Abdullbasit/vhtd-pv-pump-drive/firmware/source/README.txt

FOC source: repository root (Keil MDK project MDK-ARM/vfd_vsi_new_50k.uvprojx, drive/ MOTOR_FOC/ comm/). V/f source: ../hs300_src_0826_ota (same project name).
