Abdullbasit/vhtd-pv-pump-drive/figures/fig06_real_clouds.png

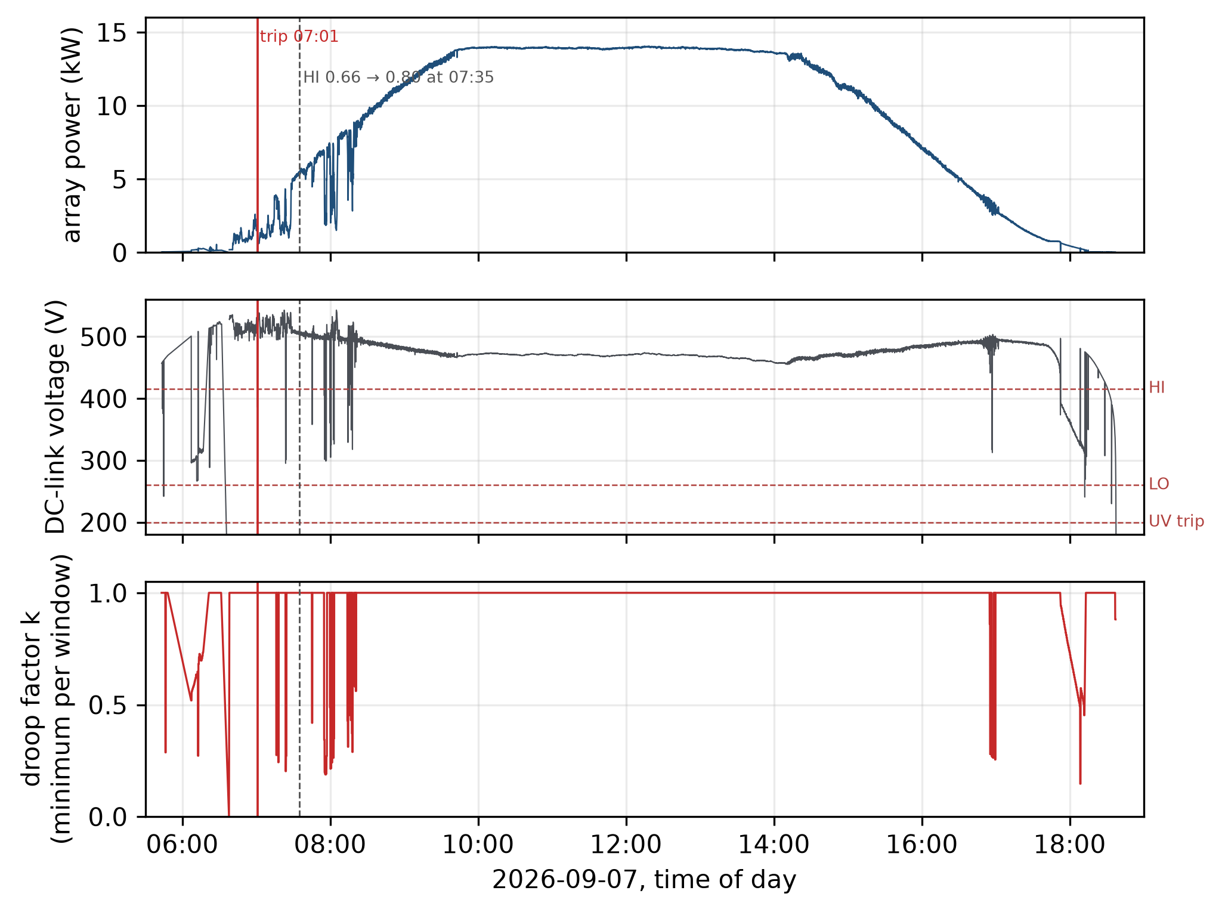
figures/fig06_real_clouds.png
