Abdullbasit/vhtd-pv-pump-drive/figures/fig09_B3_trip.png

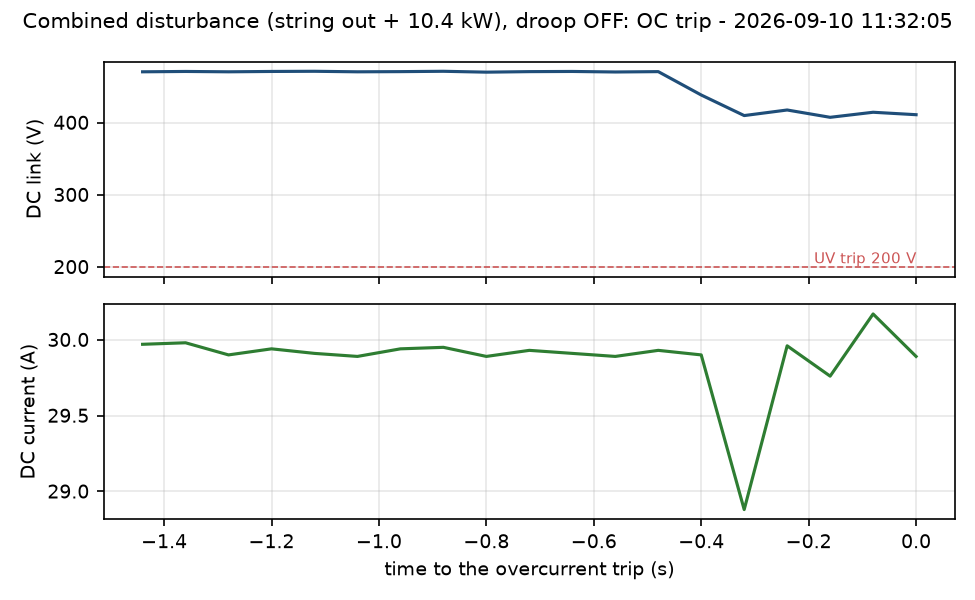
figures/fig09_B3_trip.png
