Abdullbasit/vhtd-pv-pump-drive/figures/fig10_A6_combined_droop.png

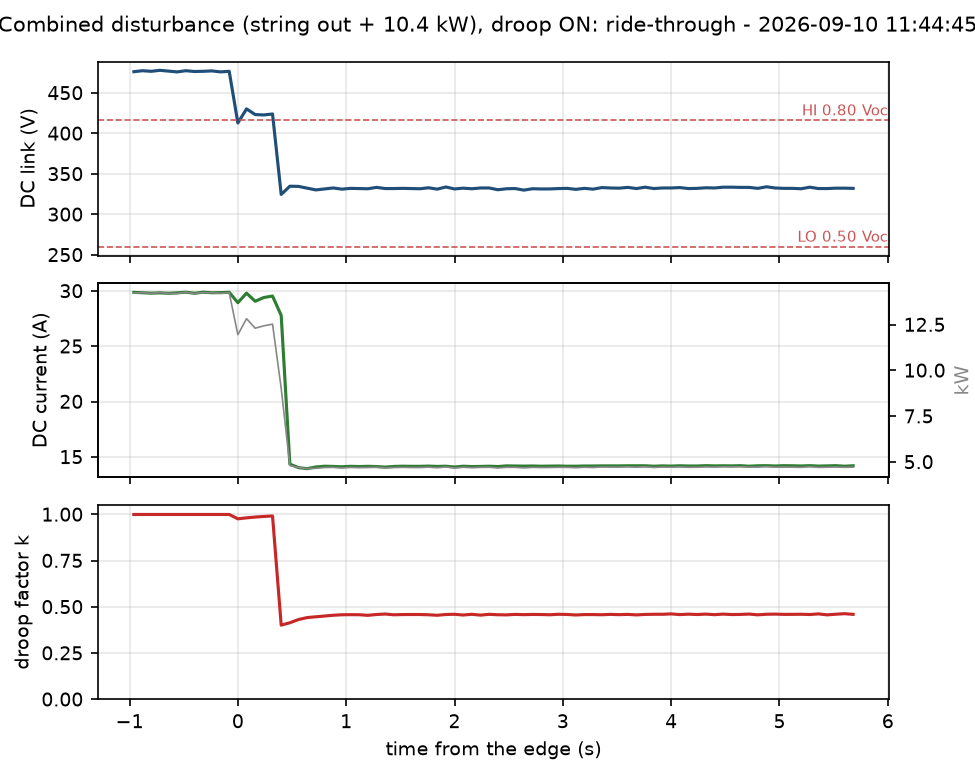
figures/fig10_A6_combined_droop.png
