Abdullbasit/vhtd-pv-pump-drive/figures/fig11_day_arc_20260910.png

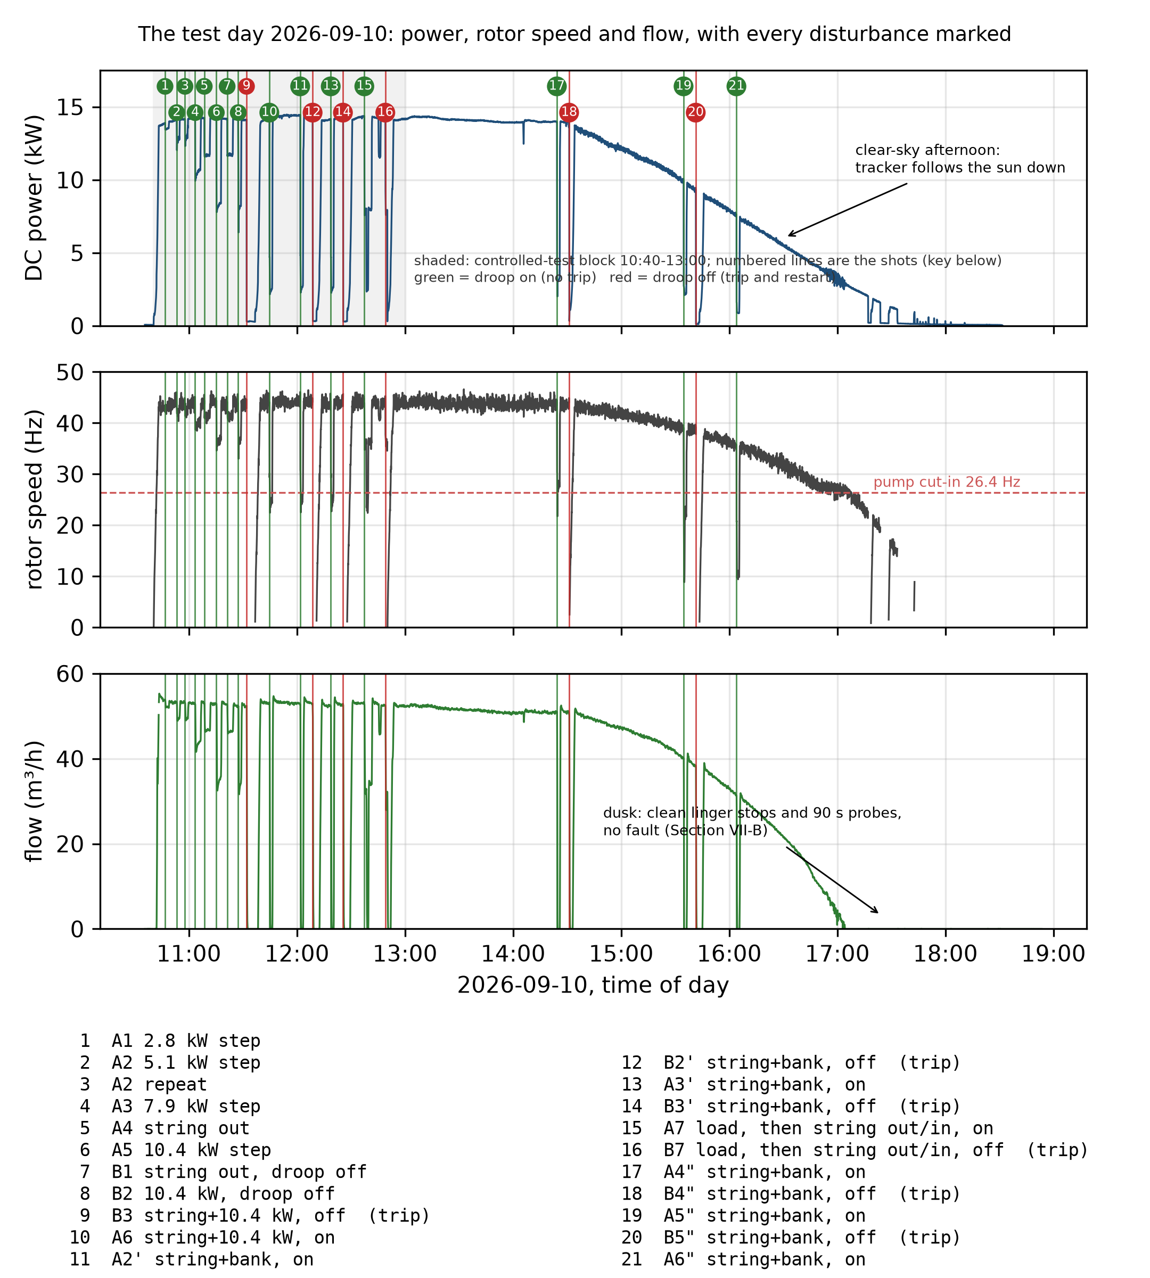
figures/fig11_day_arc_20260910.png
