Abdullbasit/vhtd-pv-pump-drive/hardware/bom_cpl_jlcpcb/notes.txt

R41,330K,1206,C144497,-49.0515,-111.604,TOP,135
R64,330K,1206,C144497,-43.9715,-110.334,TOP,135
R65,330K,1206,C144497,-50.165,-104.445,TOP,90
R68,330K,1206,C144497,-45.085,-104.445,TOP,90
R69,330K,1206,C144497,-42.2402,-119.38,TOP,180
R72,330K,1206,C144497,-36.3515,-114.779,TOP,135
R77,330K,1206,C144497,-45.2415,-115.414,TOP,135
R78,330K,1206,C144497,-40.1615,-114.144,TOP,135
AC1,CONN-SIL4,XH_254_4P2,C5341203,-40.64,-123.19,TOP,180
