Abdullbasit/vhtd-pv-pump-drive/figures/fig07_step_5kW.png

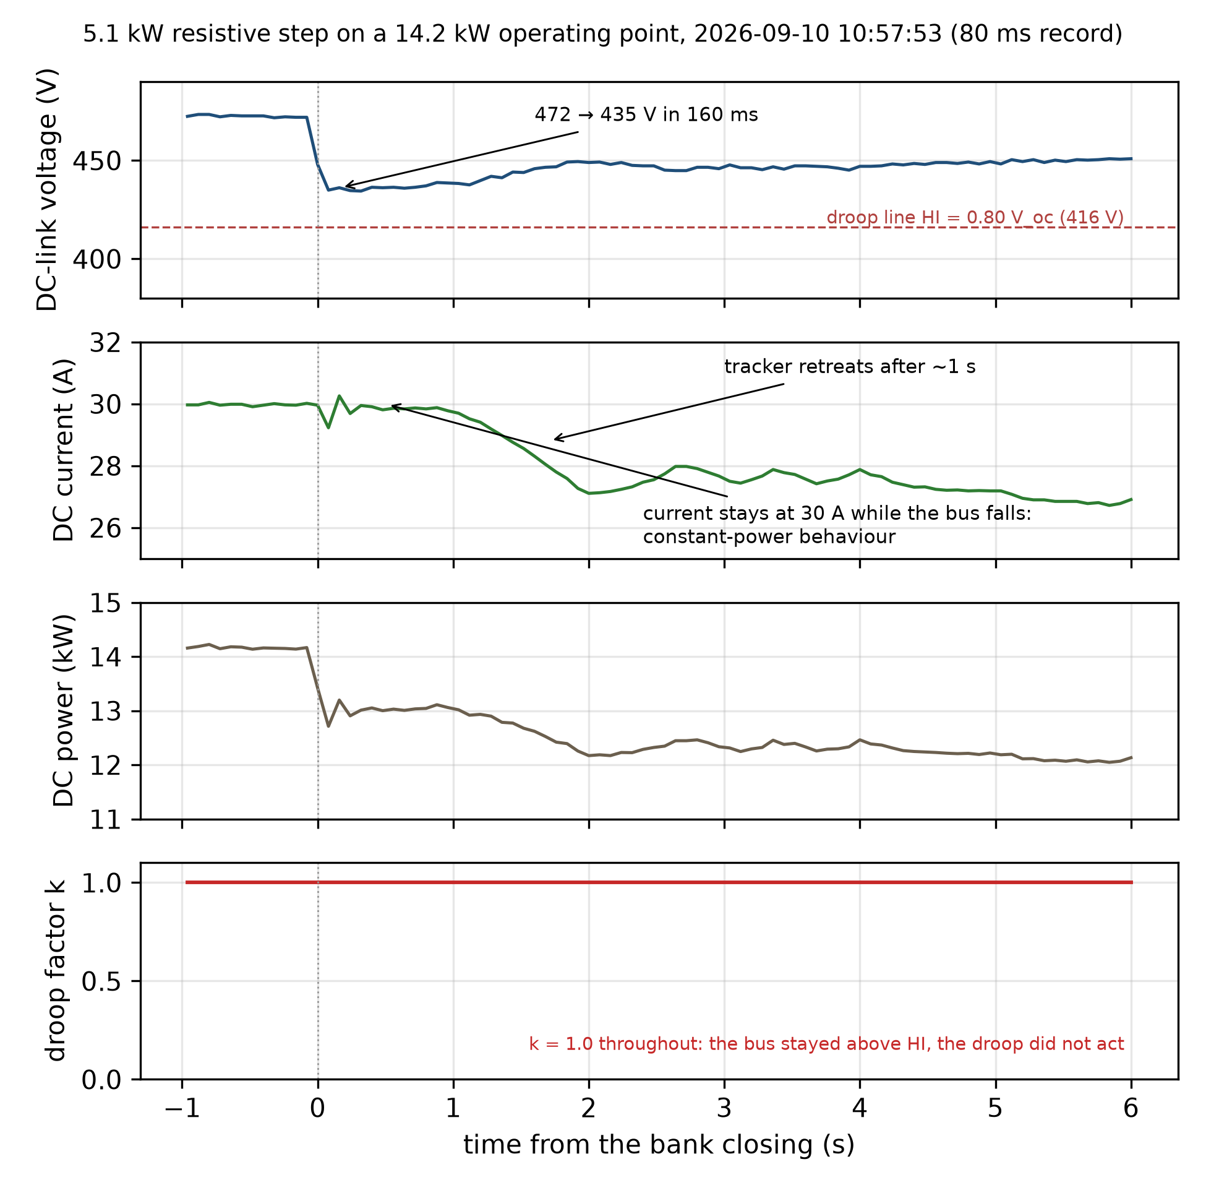
figures/fig07_step_5kW.png
