Abdullbasit/vhtd-pv-pump-drive/figures/fig08_step_12kW_droop.png

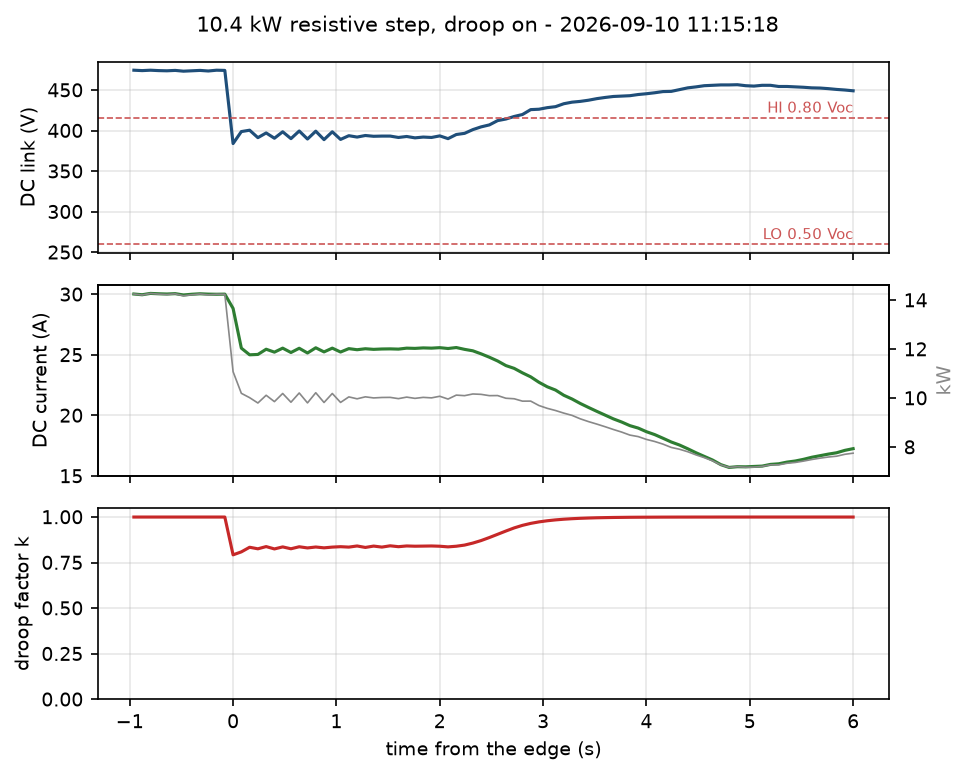
figures/fig08_step_12kW_droop.png
