Abdullbasit/vhtd-pv-pump-drive/figures/fig15_setup_schematic.png

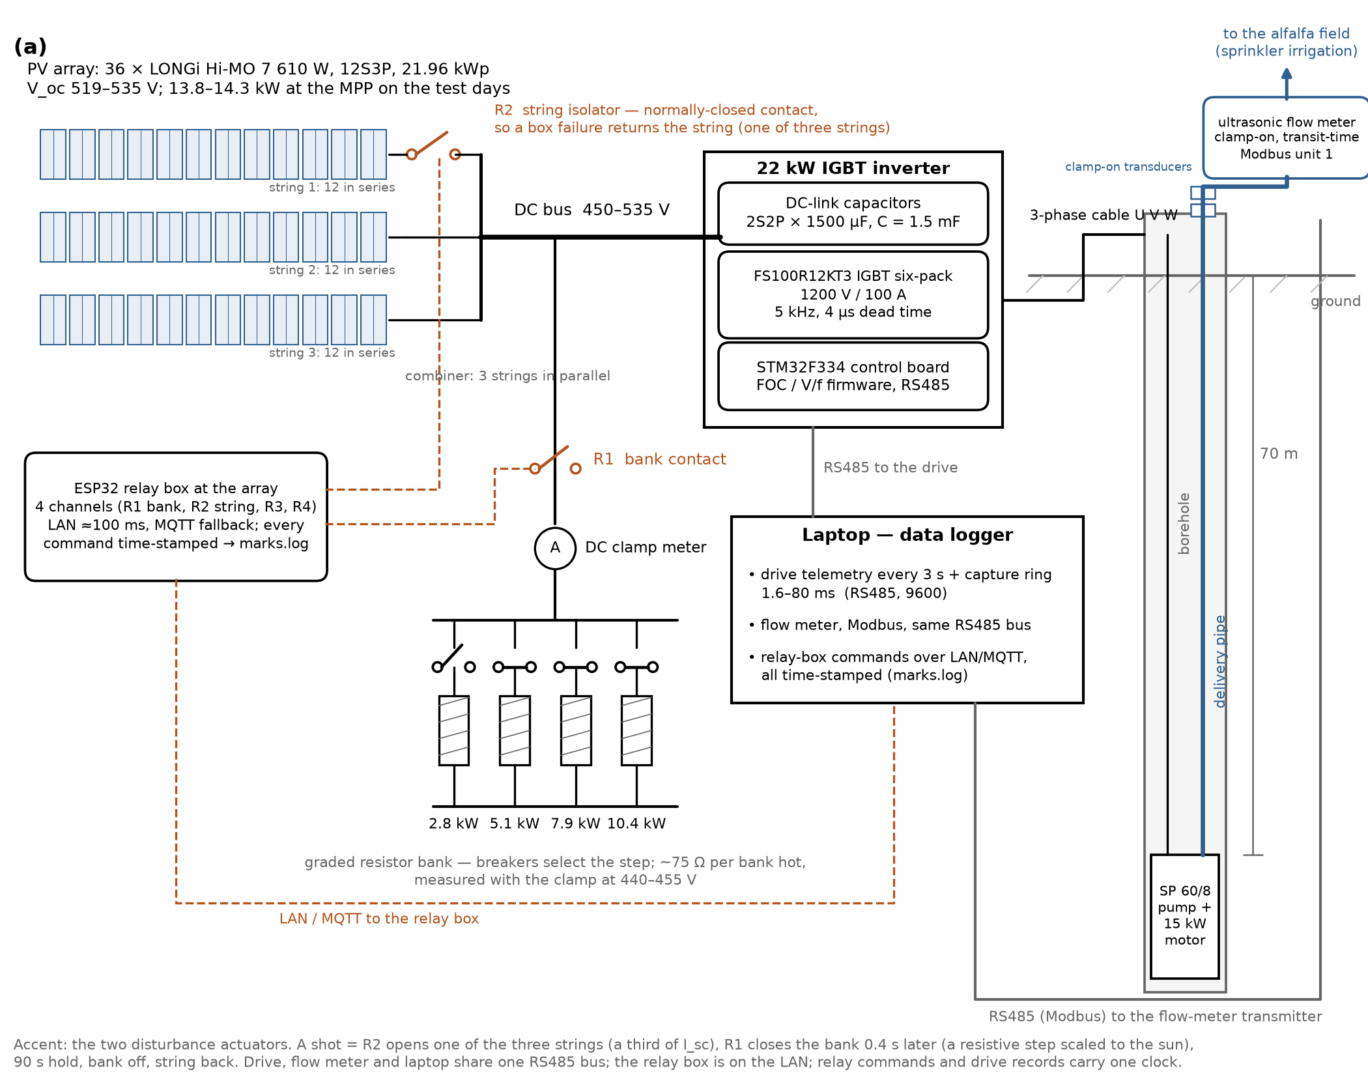
figures/fig15_setup_schematic.png
