Abdullbasit/vhtd-pv-pump-drive/figures/fig15b_setup_photos.png

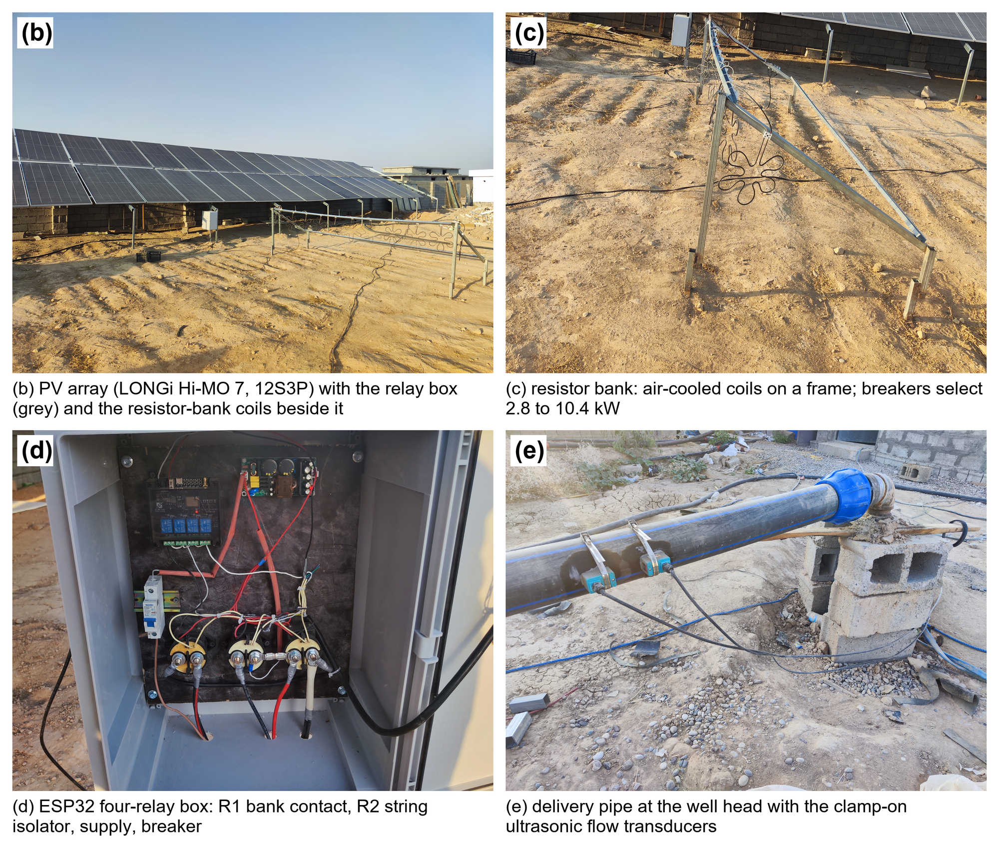
figures/fig15b_setup_photos.png
