Abdullbasit/vhtd-pv-pump-drive/figures/fig15c_setup_photos.png

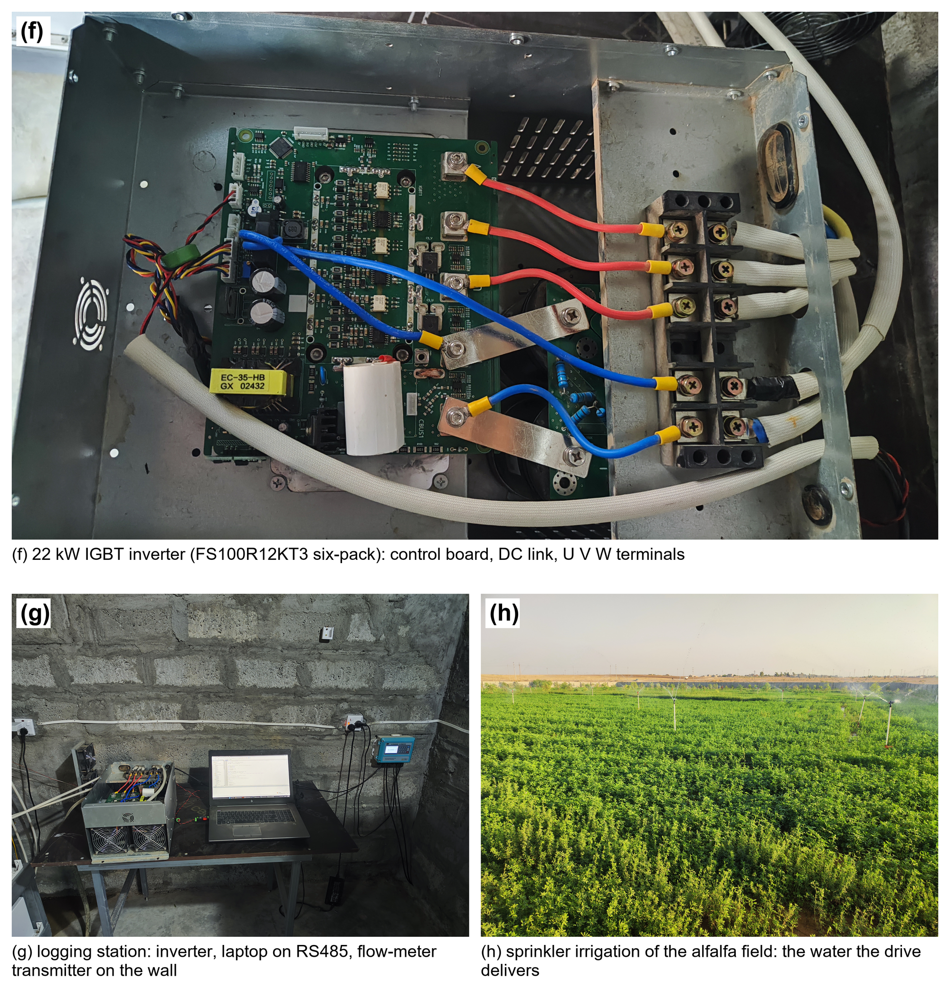
figures/fig15c_setup_photos.png
