Abdullbasit/vhtd-pv-pump-drive/hardware/schematics/HS300_sch_1_mcu.pdf

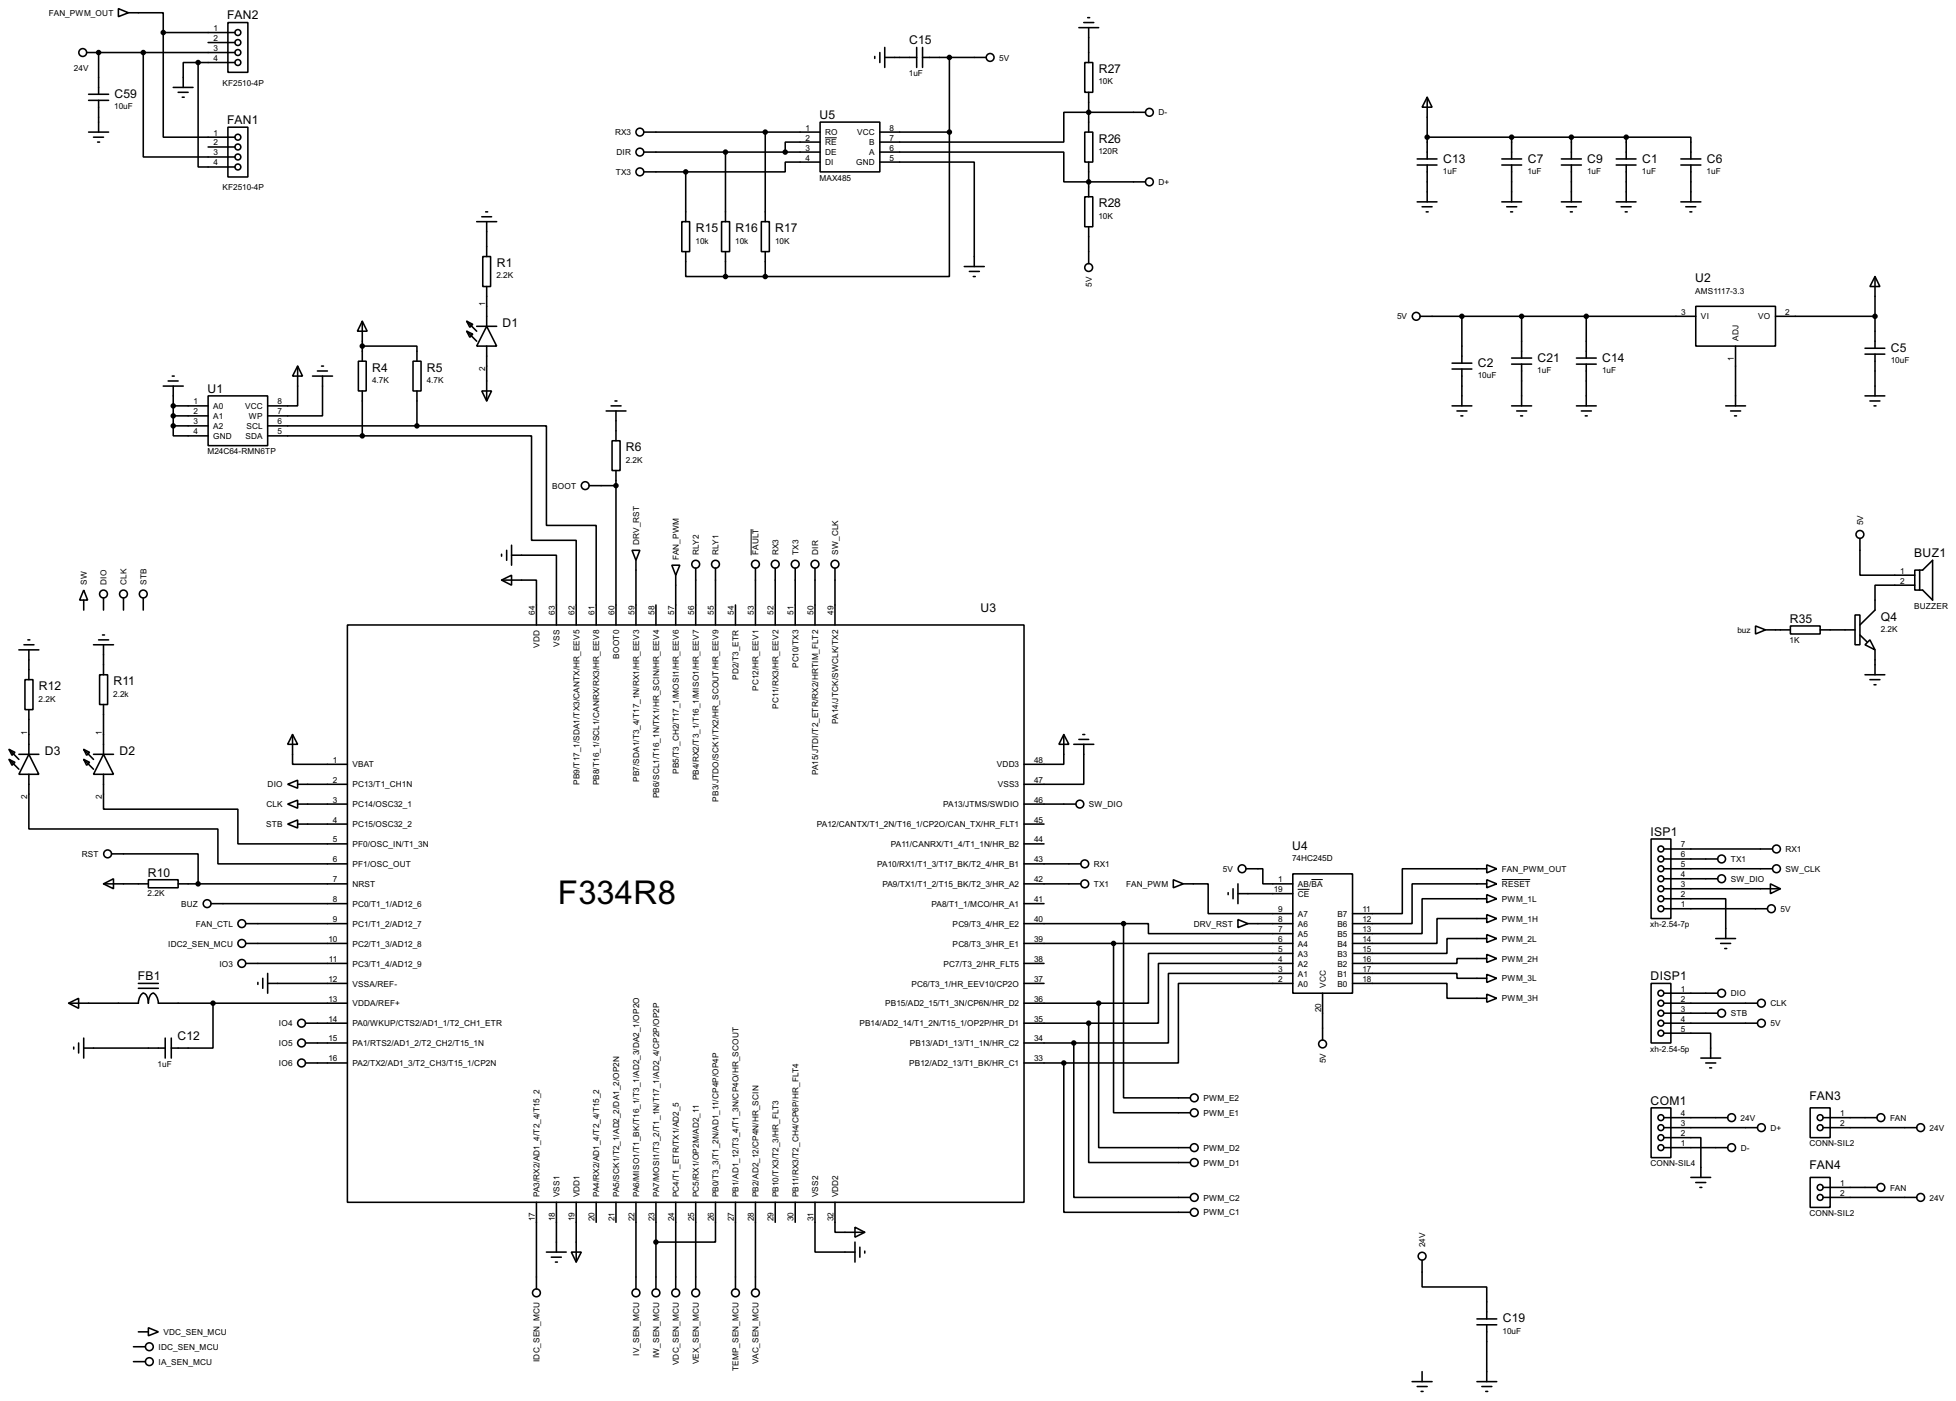
[picture p25: page 1]
