Abdullbasit/vhtd-pv-pump-drive/hardware/schematics/HS300_sch_2_gate_drivers.pdf

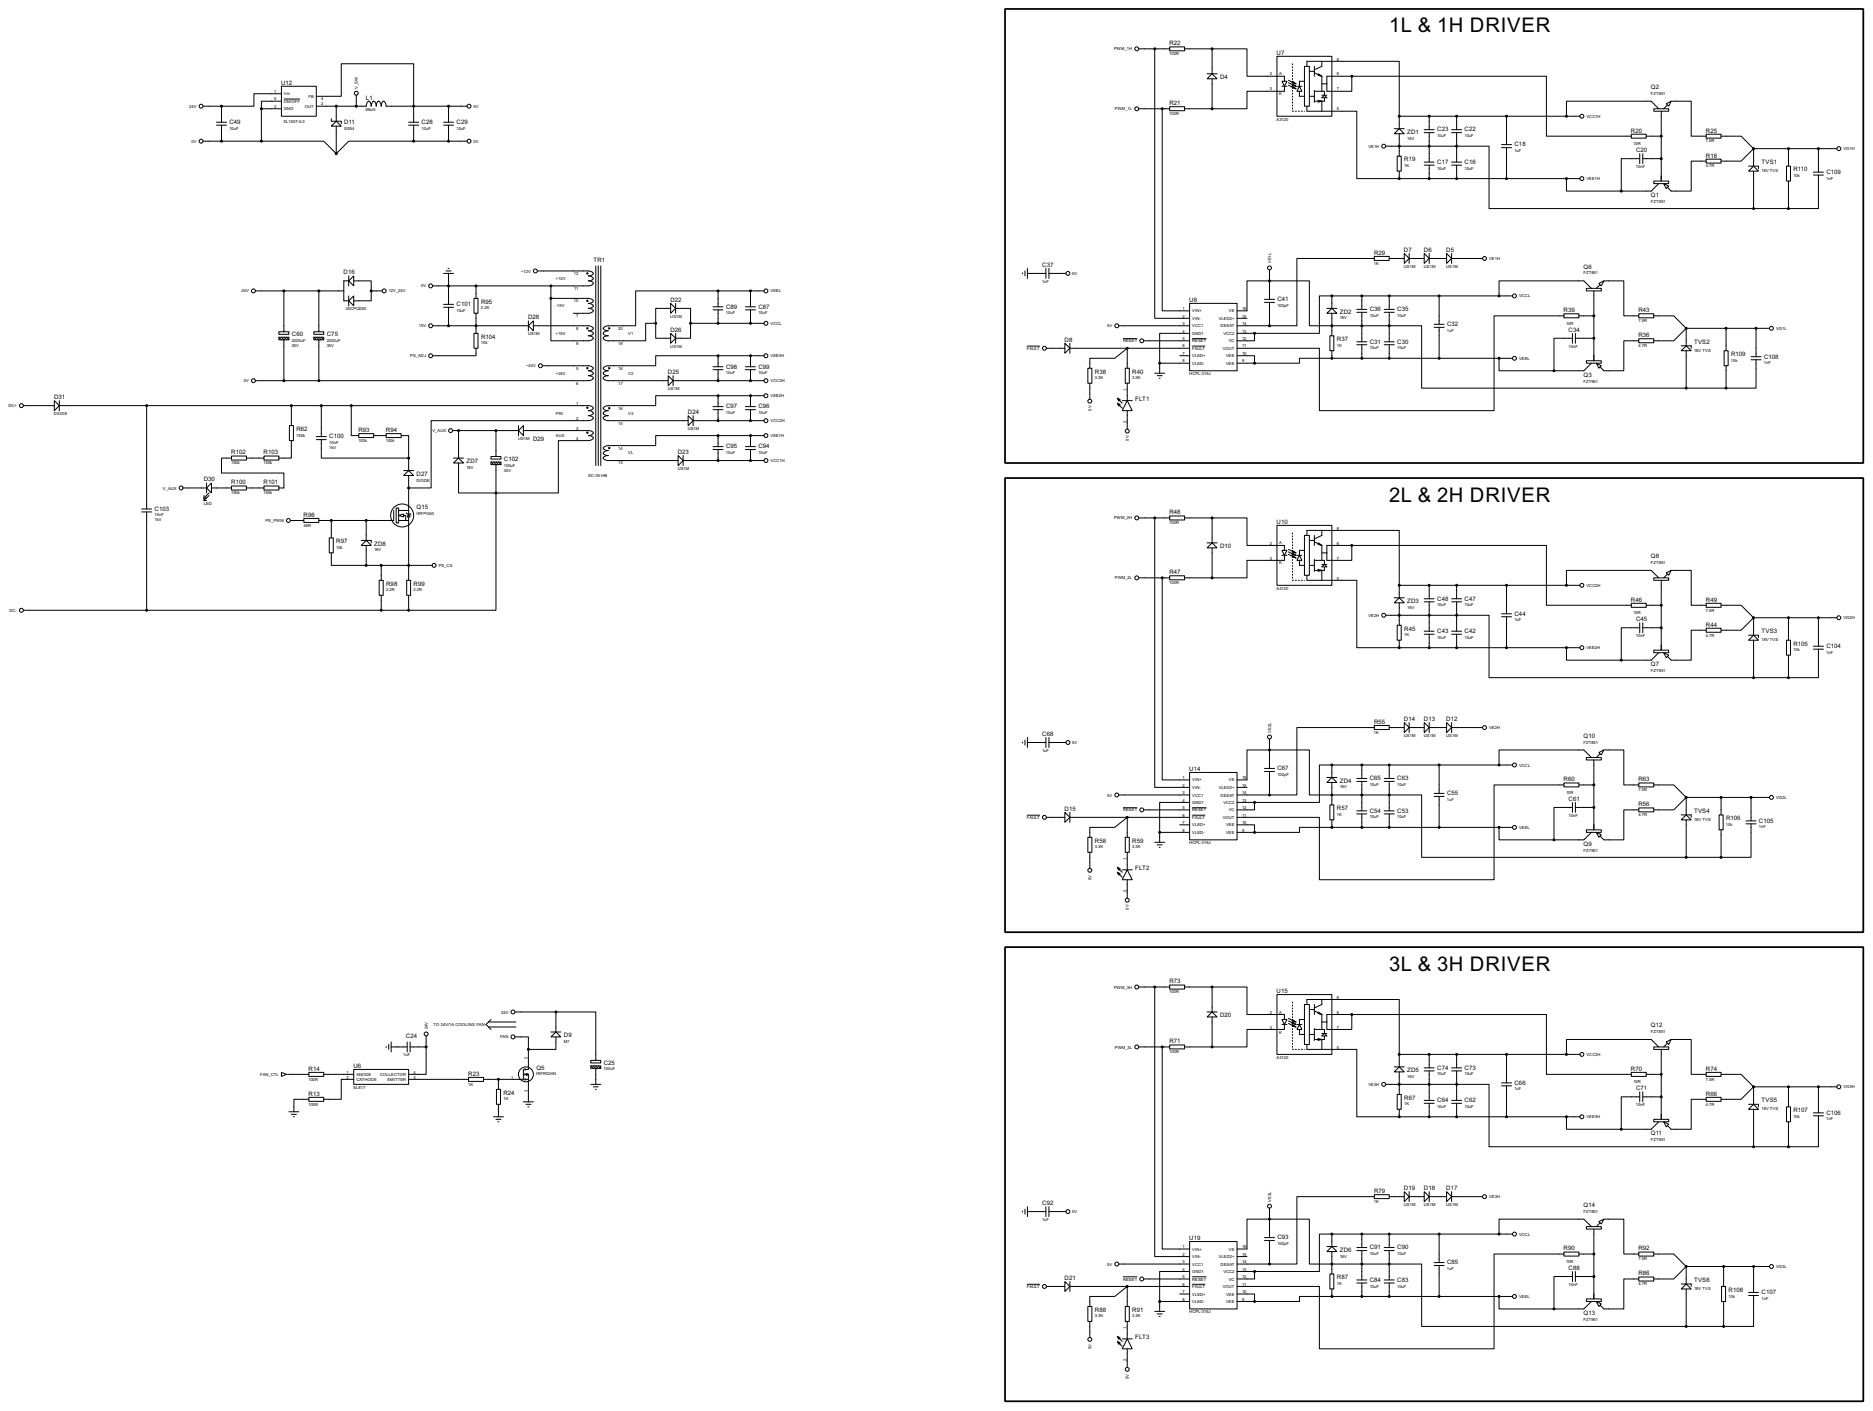
[picture p26: page 1]
