Abdullbasit/vhtd-pv-pump-drive/hardware/schematics/HS300_sch_3_measurement.pdf

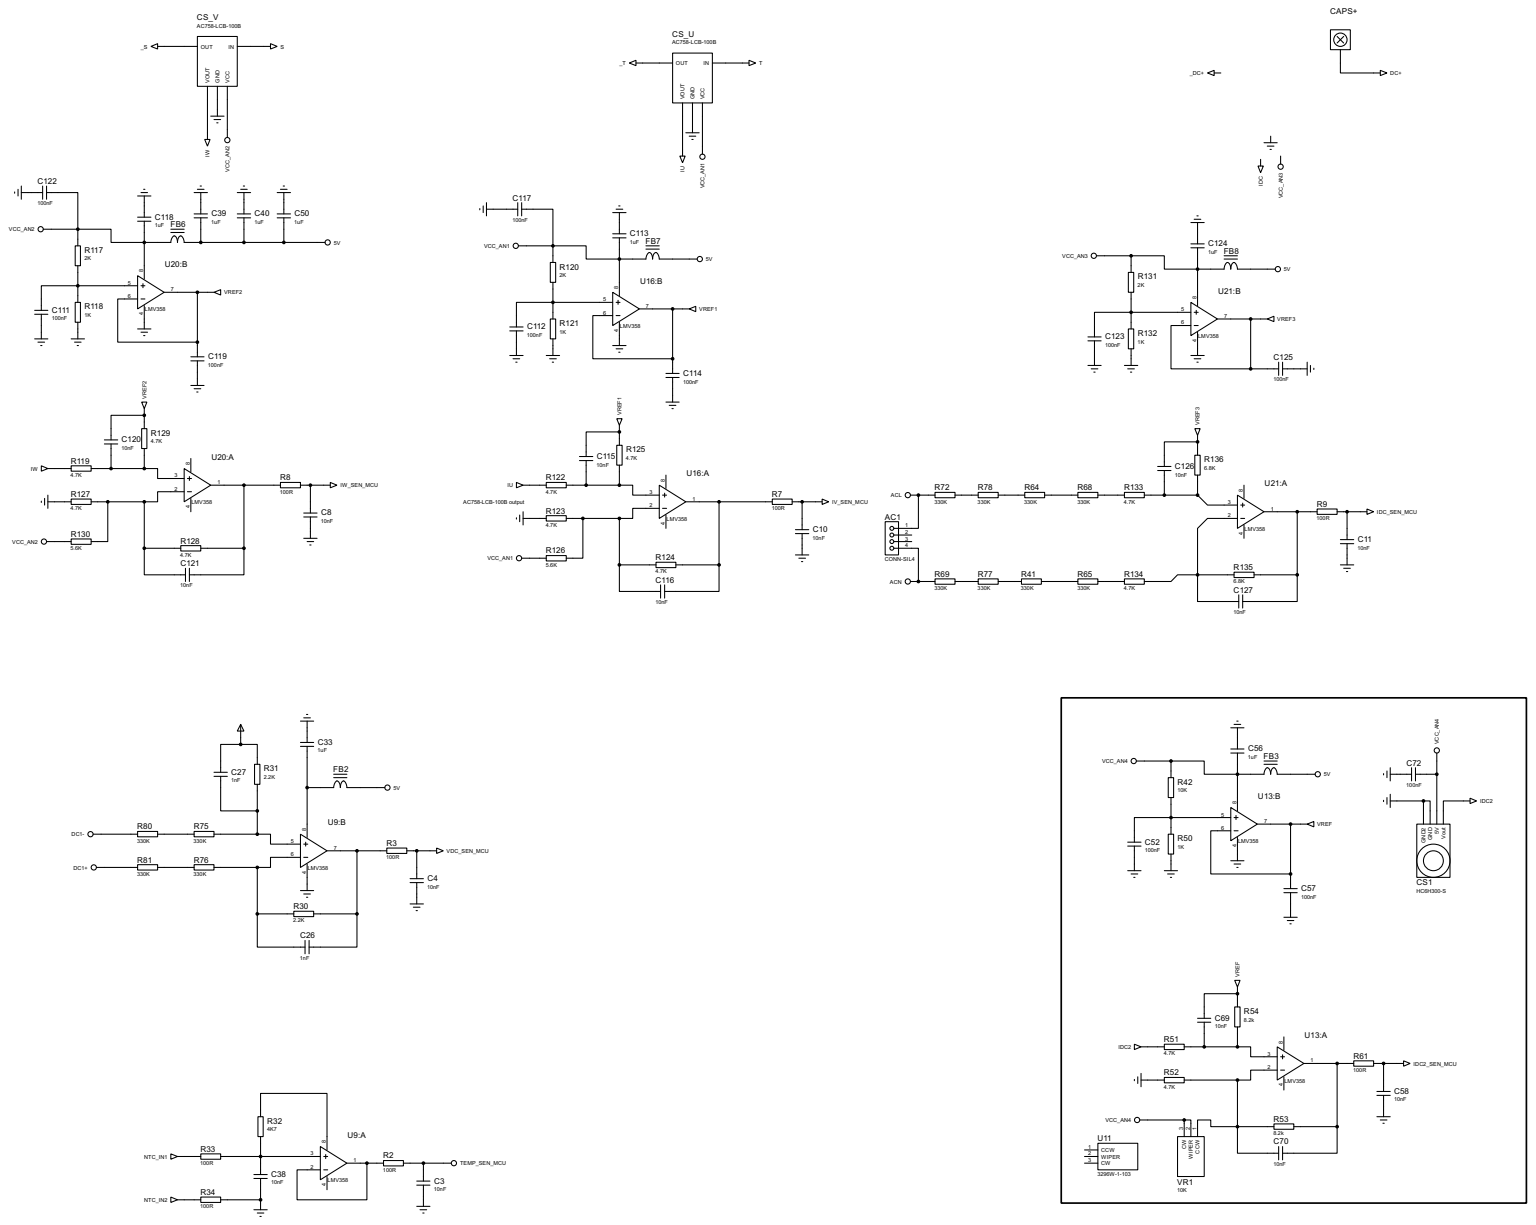
[picture p27: page 1]
