Abdullbasit/vhtd-pv-pump-drive/hardware/schematics/HS300_sch_4_power_stage.pdf

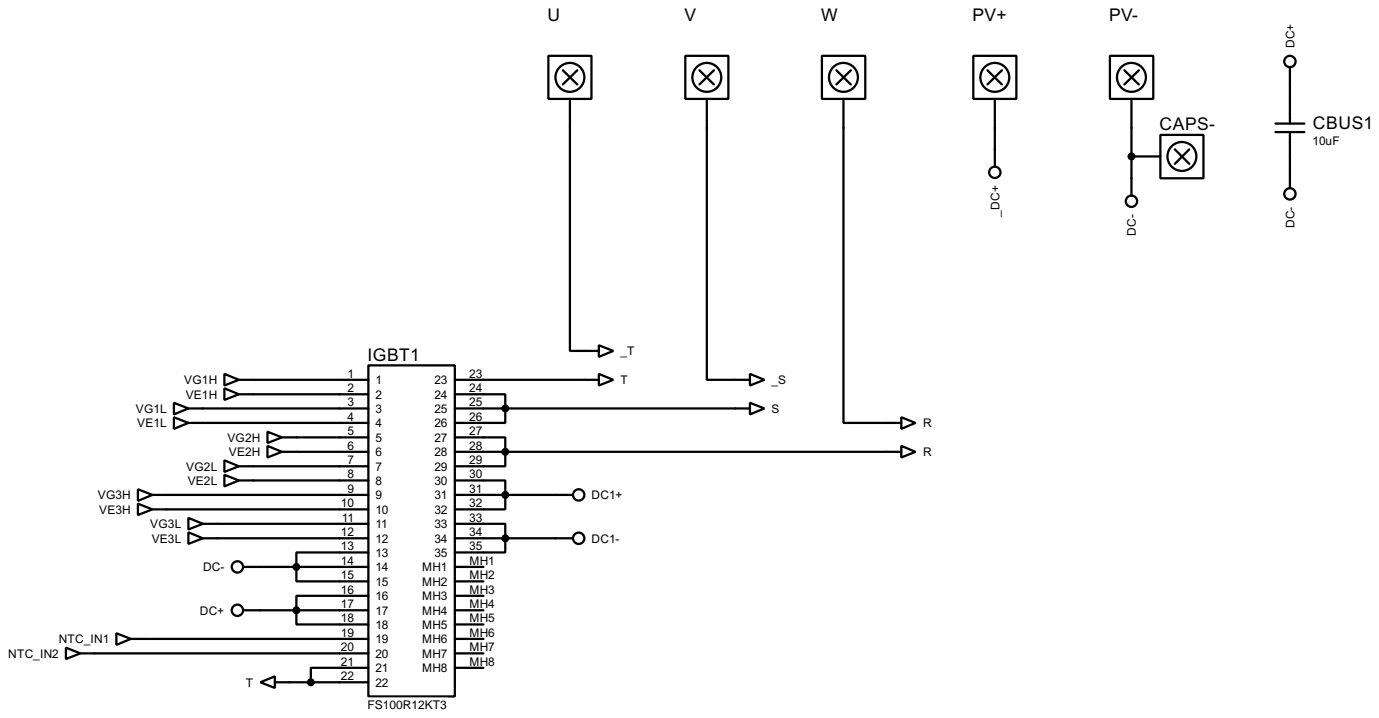
[picture p28: page 1]
