Abdullbasit/vhtd-pv-pump-drive/hardware/schematics/HS300_sch_4_power_stage_orig_label.pdf

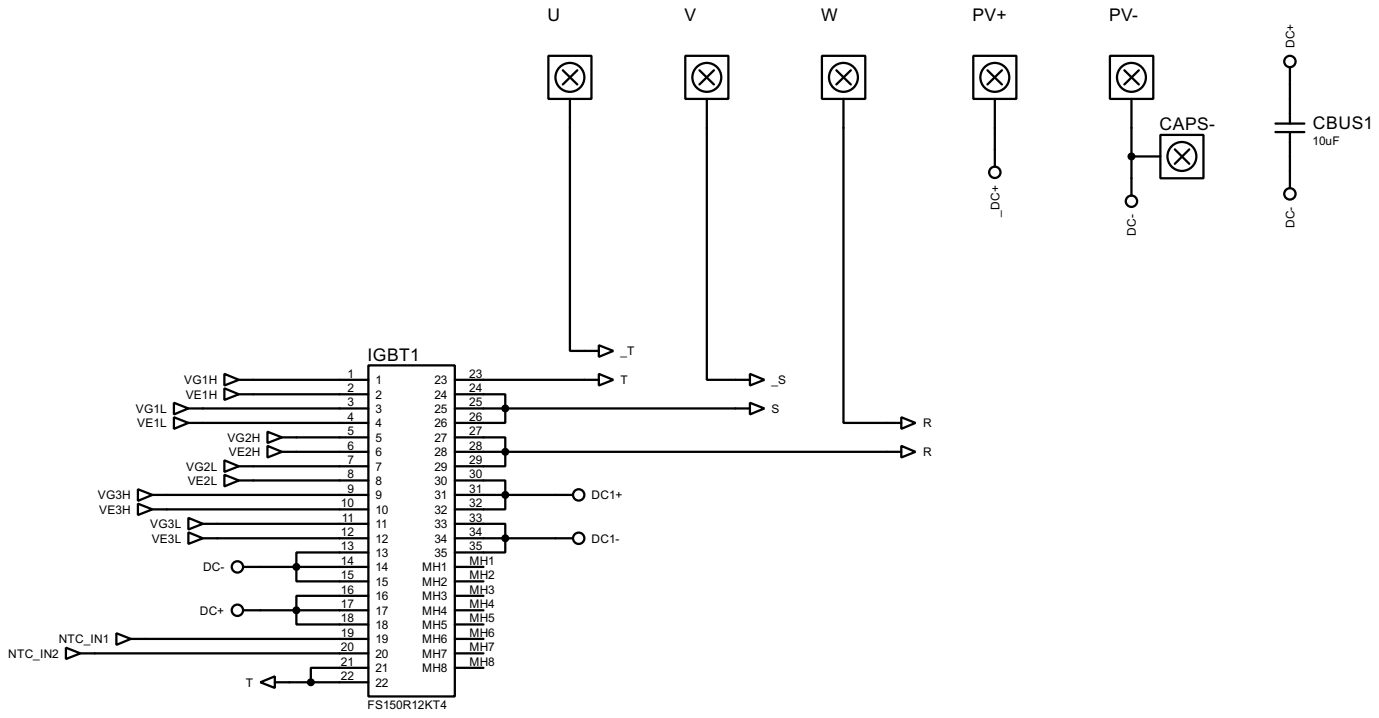
[picture p29: page 1]
