Abdullbasit/vhtd-pv-pump-drive/hardware/schematics/HS300_schematics_all.pdf

## CS_U

FB7


S | R NTC_IN1 NTC_IN2 | 1 1 | 2 2 | 3 3 | 4 4 | 5 5 | 6 6 | 7 7 | 8 8 | 9 9 | 10 10 | 11 11 | 12 12 | 13 13 | 14 14 | 15 15 | 16 16 | 17 17 | 18 18 | 19 19 | 20 20 | 21 21 | 22 22 | 23 | 23 24 | 24 25 | 25 26 | 26 27 | 27 28 | 28 29 | 29 30 | 30 31 | 31 32 | 32 33 | 33 34 | 34 35 | 35 MH1 | MH1 MH2 | MH2 MH3 | MH3 MH4 | MH4 MH5 | MH5 MH6 | MH6 MH7 | MH7 MH8 | MH8 IGBT1 VG1H VE1H VG2H VE2H VG3H VE3H VG1L VE1L | VG2L VE2L VG3L VE3L | DC+ DC- | T T | CBUS1 10uF DC⁻ DC⁺ U | V | W | PV+ | PV- _DC⁺ | DC⁻ _T | _S | R DC1+ DC1- | CAPS-

### FS100R12KT3
