Abdullbasit/vhtd-pv-pump-drive/(commit log)

2026-09-23 Data and code for the VHTD PV-direct pump drive paper
    Firmware sources and the CRC-named binaries that were flashed, the hardware
    design files, the raw instrument records of every test day, the figure and
    logging scripts, and the dashboard behind the interactive record.
    README maps every figure and table to the data and the script behind it.
    MIT for the code, CC BY 4.0 for the data.
    [e2_vf_20260914_121258_mppt_auto.csv, e2_vf_20260914_121654_mppt_run.csv, e2_vf_20260914_122454_shot2.csv, e2_vf_20260914_122602_shot2.csv, e2_vf_20260914_125310_retreat.csv, e2_vf_20260914_130016_retreat2000.csv, e2_vf_20260914_130716_retreat2000diag.csv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]
2026-09-24 Landing page for GitHub Pages, so one link reaches everything
    index.html points at the interactive record, the repository and the DOI.
    .nojekyll keeps Pages from trying to build 6800 data files as a Jekyll site.
2026-09-24 README: link the interactive record and the landing page
2026-10-26 The array I-V of 2026-09-25, which Data Availability already claimed
    Data Availability in the manuscript, and S1 of the supplement, both cite
    data/array_iv_20260925.csv by name. The file was never pushed: the path
    returned 404 and logs/ stops at 20260914. The v1.0 Zenodo snapshot is dated
    23 September, two days before the measurement, so it cannot have held it
    either.
    28 rows: one, two and three strings in parallel, each loaded through the
    graded resistor bank from open circuit to short circuit, V at the combiner
    terminals and I by DC clamp on the string lead. The header records the
    method, the meter and its accuracies. These are the numbers behind Table S1
    and the normalised curve used thr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
2026-10-26 The dawn probe panel counted the lifetime start counter
    Fig. 3 of the supplement says ten start attempts, nine of them probes
    between 05:59 and 06:16 and the tenth holding at 06:18:31. The script
    plotted something else: `starts` is the drive's LIFETIME start counter, and
    solar_day_20260908.csv carries it as an EMPTY FIELD until the first energise
    answers at 06:07:16, by which time it already reads 1189. Reading those
    blanks as a real zero baselined the panel on a count that was never
    measured, so it drew 0 -> 1189 -> 1196: an axis reaching 1200 under a
    caption that says ten, and a step at 06:07 that was the first reading
    arriving rather than a start.
    Blanks are missing, not zero. The panel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
2026-10-26 Keep the field EEPROM backups out of this public tree
    disaster_recovery/ holds per-board EEPROM and firmware dumps taken during
    commissioning - four sets of them are sitting untracked in this working tree
    right now, because the PC's release/ folder is both this repo's checkout and
    where drive_backup.py writes. They are a customer's board settings, not part
    of the deposit, and one `git add -A` would publish them.
    Claude-Session: https://claude.ai/code/session_01D75uRUJnkmnMEM3rvBUF23
